etherkit/PartyLine80/README.md

# Party Line 80

## All-Discrete 80 Meter CW QRP Transceiver

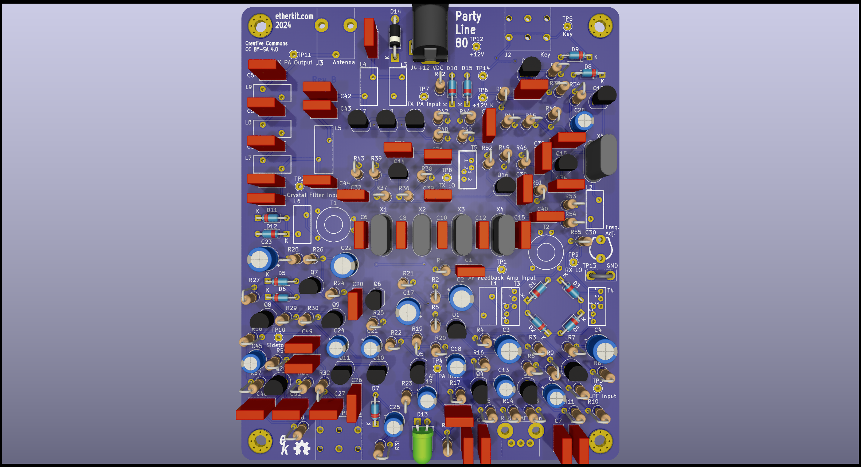
[picture p1: Documentation/PartyLine80Front.png]
Party Line 80 PCB
