etherkit/PartyLine80/Documentation/PartyLine80BlockDiagram.png

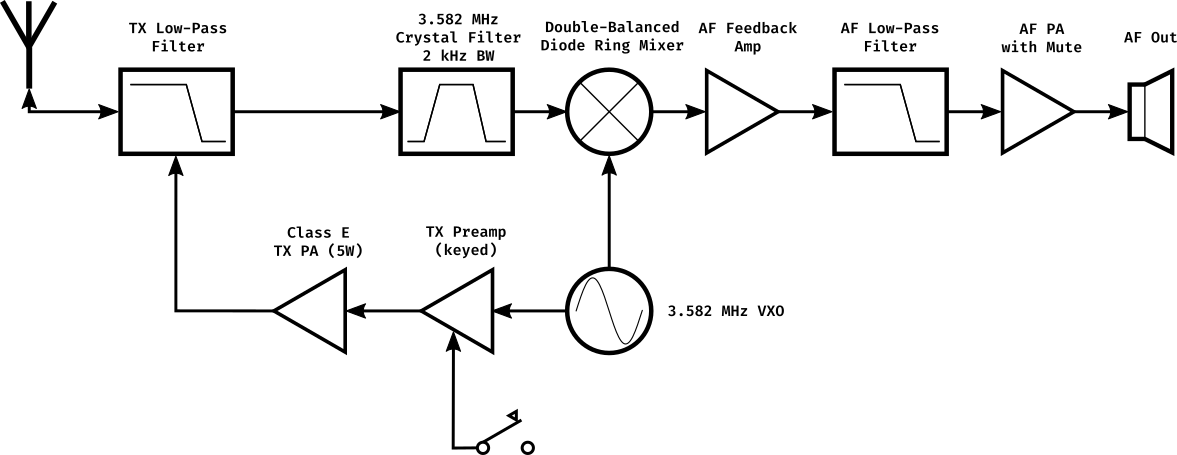
Documentation/PartyLine80BlockDiagram.png
