etherkit/PartyLine80/PCB/PartyLine80-Receiver.png

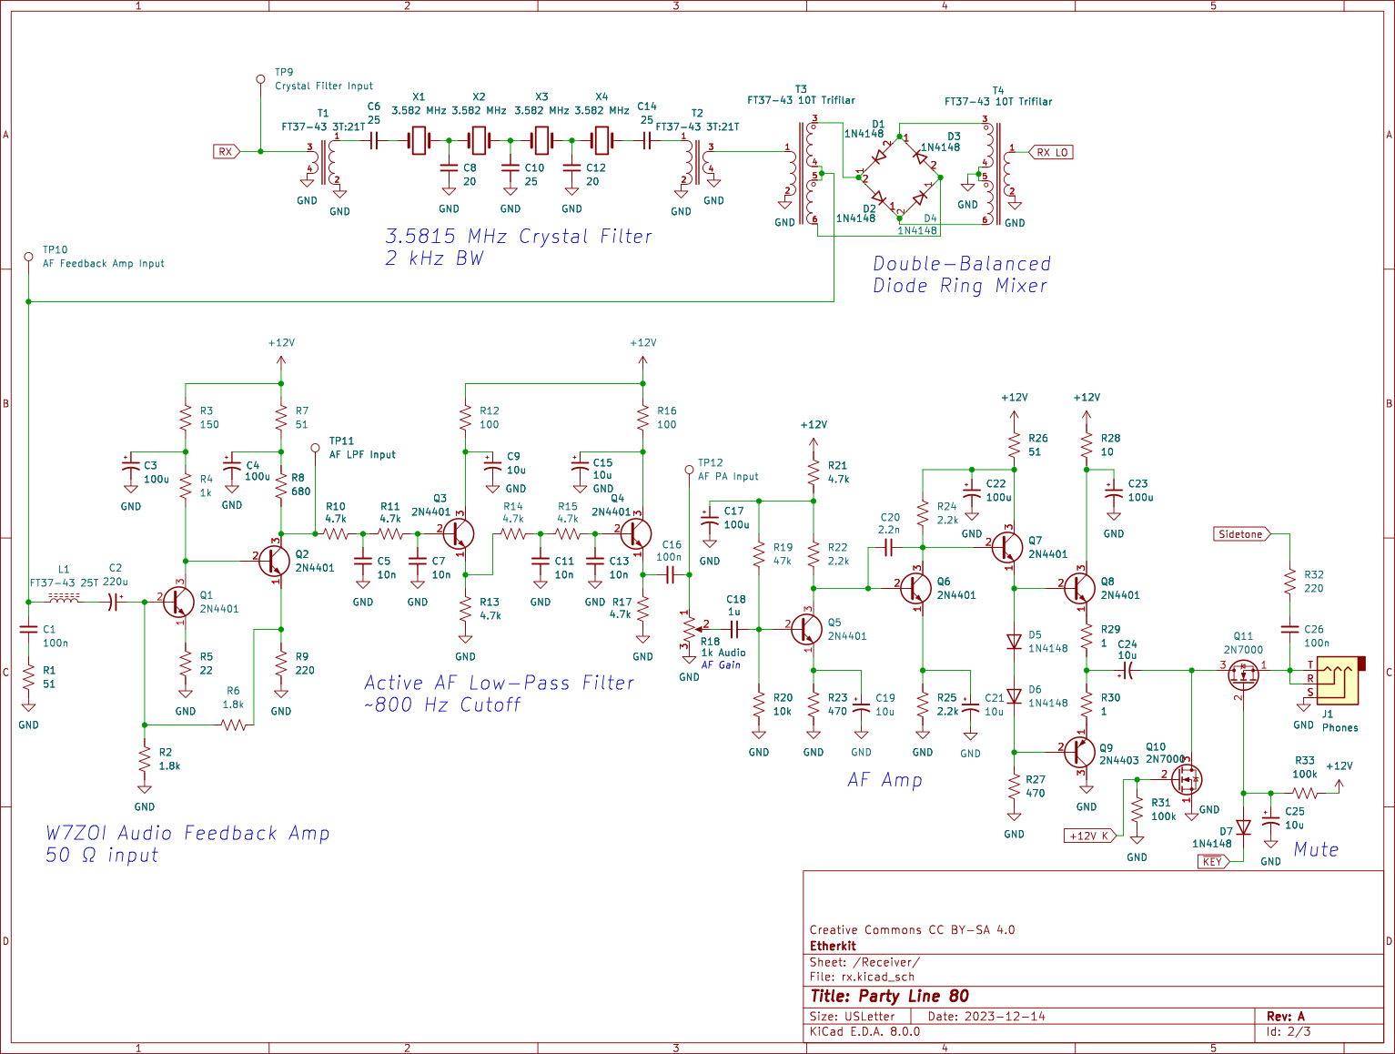
PCB/PartyLine80-Receiver.png
