etherkit/PartyLine80/Mechanical/PartyLine80CaseTop.FCStd

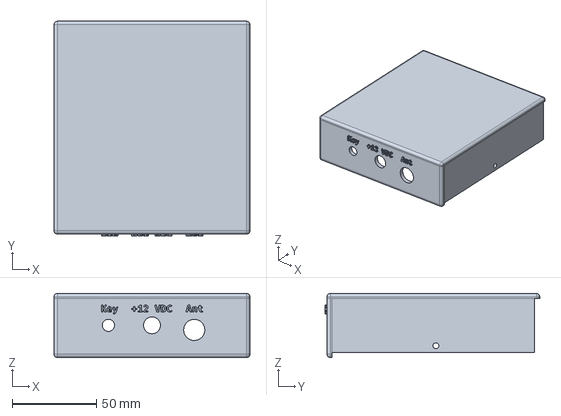
[picture p4: CAD file, 2024-05-25]
Mechanical/PartyLine80CaseTop.FCStd
116.0 x 127.0 x 38.0 mm
