etherkit/PartyLine80/Mechanical/PartyLine80CaseBottom.FCStd

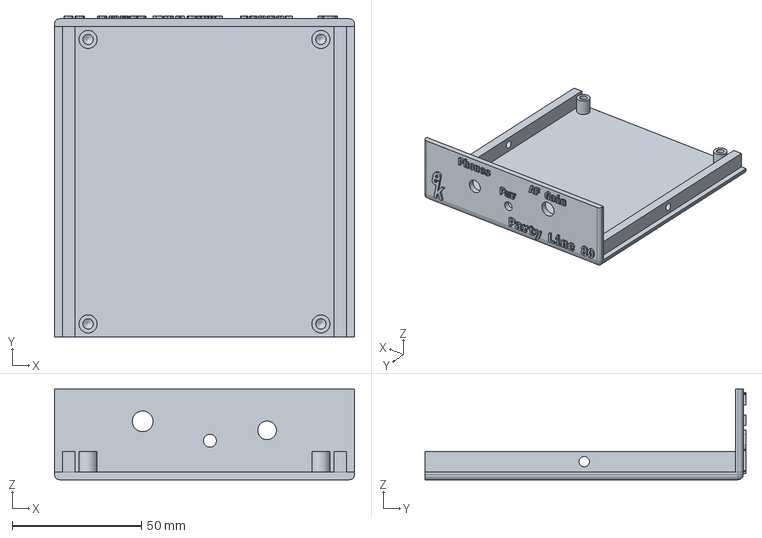
[picture p5: CAD file, 2024-05-25]
Mechanical/PartyLine80CaseBottom.FCStd
116.0 x 124.0 x 35.0 mm
