etherkit/PartyLine80/(list of files, cad)

Other CAD files:
Mechanical/PartyLine80CaseBottom.stl
Mechanical/PartyLine80CaseTop.stl
