etherkit/PartyLine80/Documentation/PartyLine80.pdf

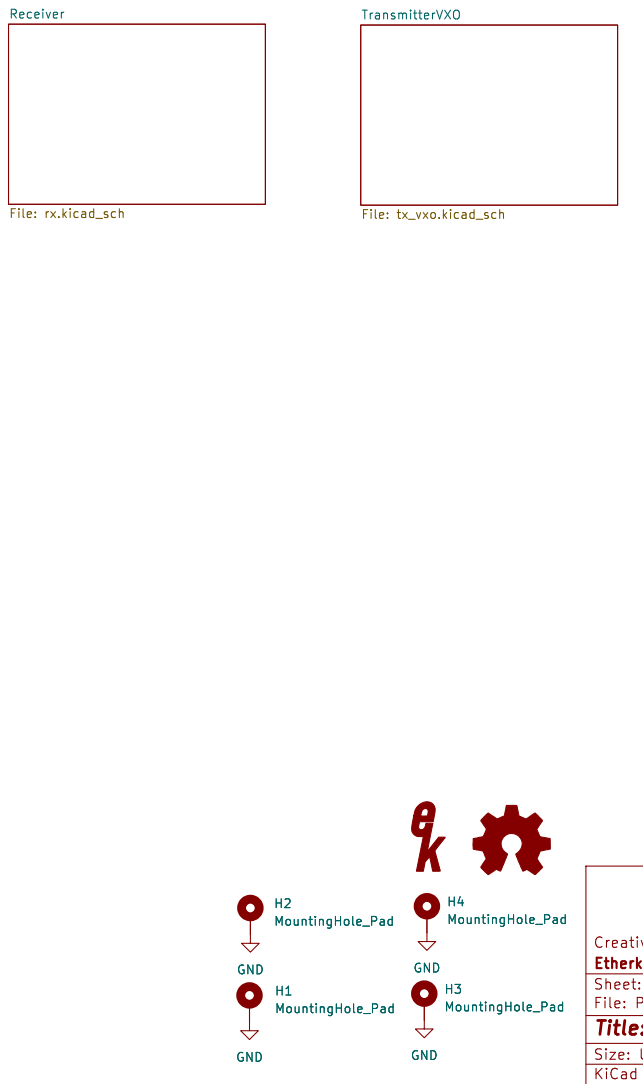
[picture p6: page 1]

Id: 1/3 Title: Party Line 80

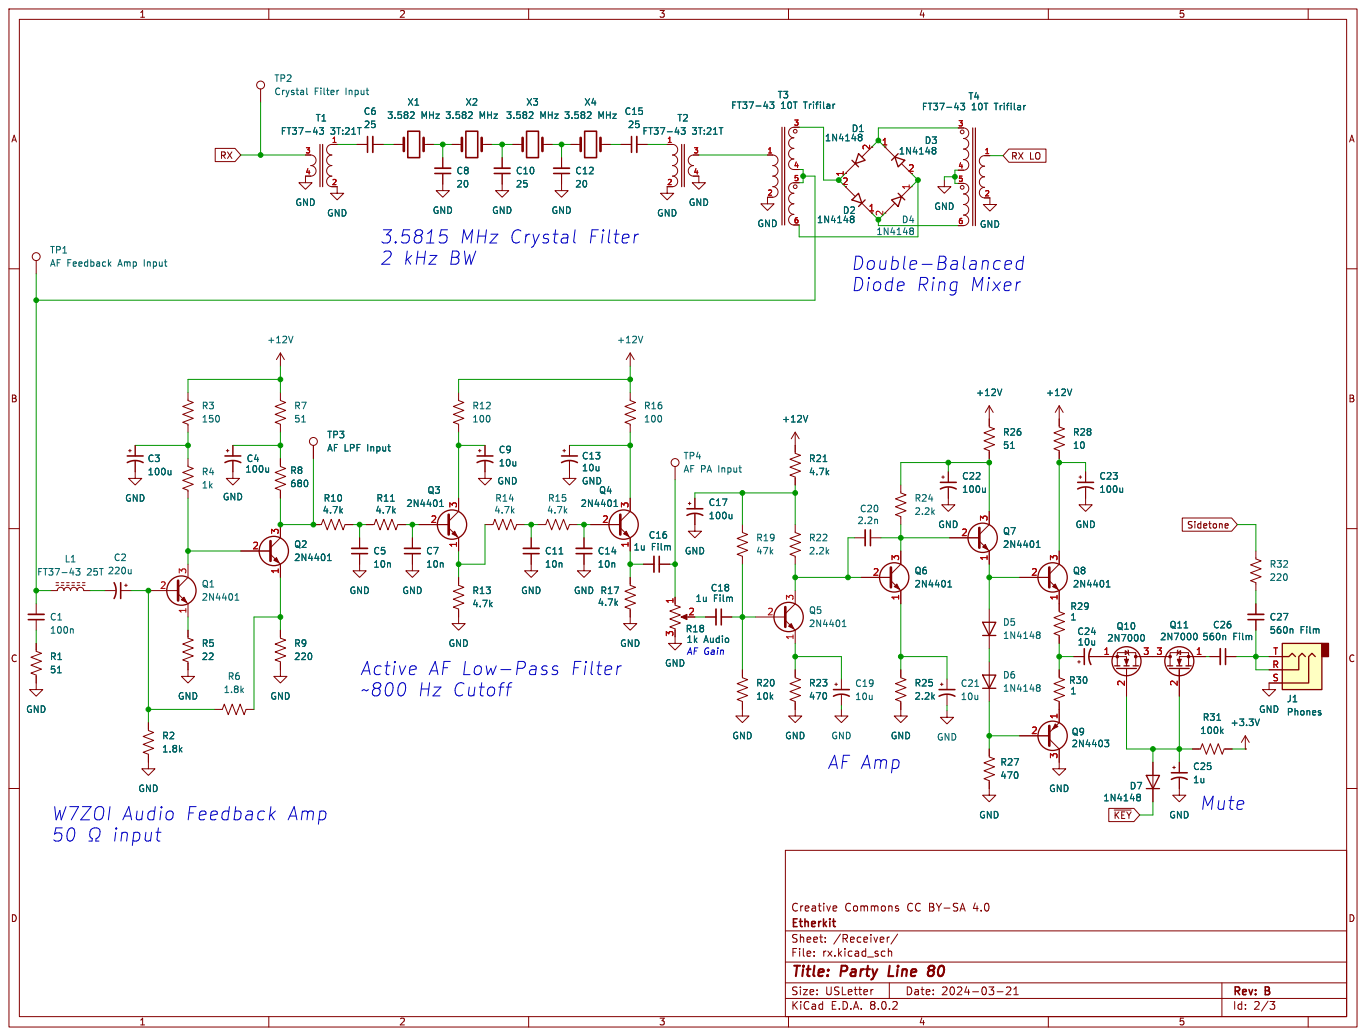
[picture p7: page 2]

Mute W7ZOI Audio Feedback Amp

Id: 2/3 Title: Party Line 80

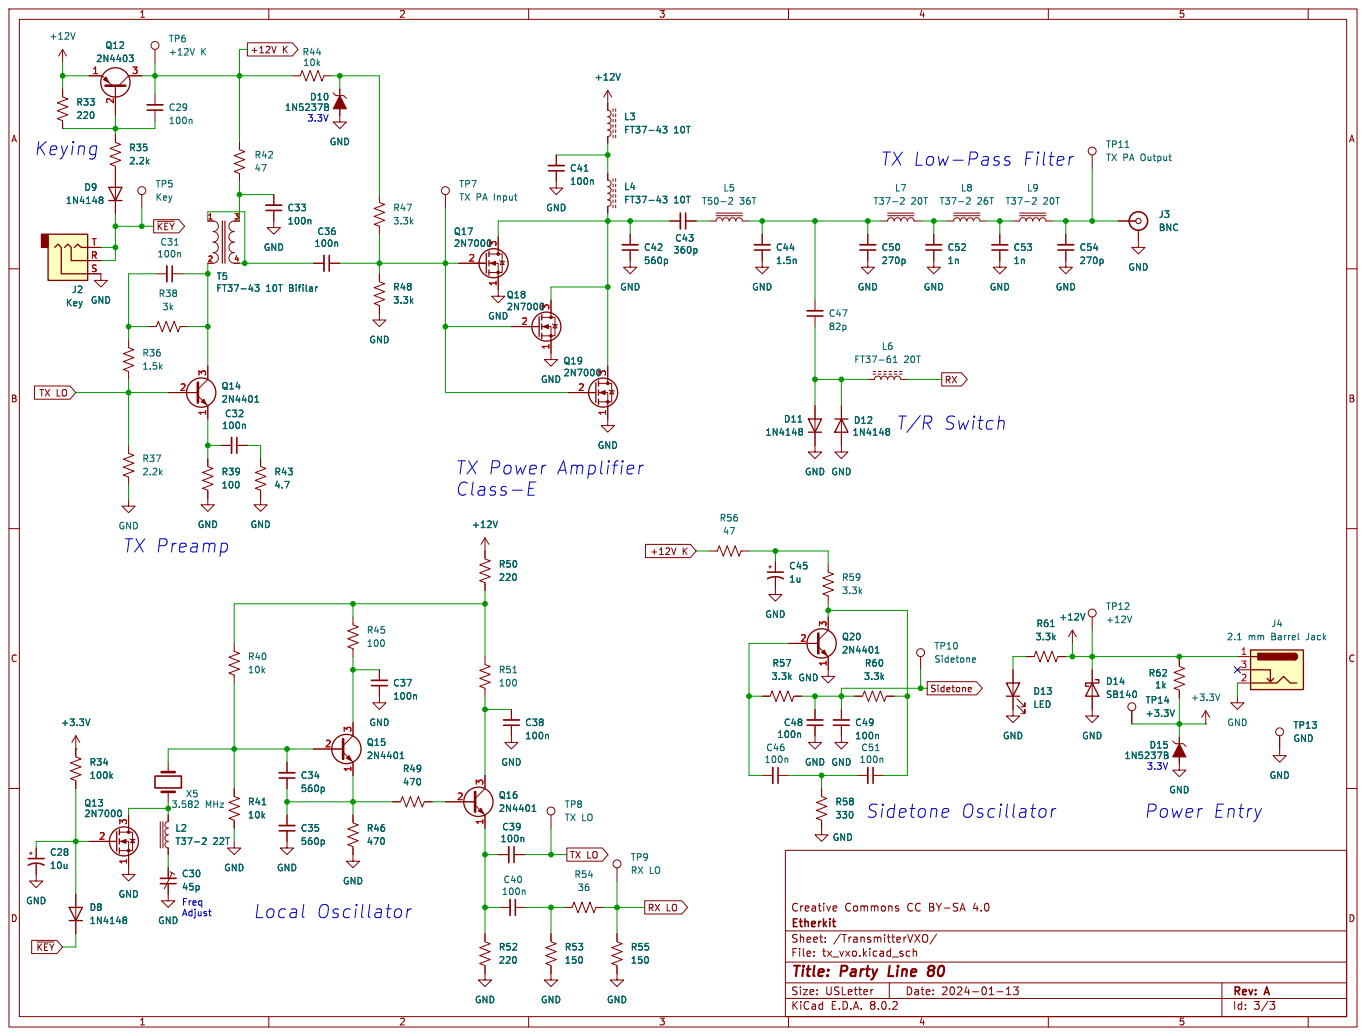
[picture p8: page 3]

2.1 mm Barrel Jack GND

Id: 3/3 Title: Party Line 80
