etherkit/PartyLine80/PCB/PartyLine80.kicad_pcb

## KiCad design PCB/PartyLine80.kicad_pcb (2024-05-25)

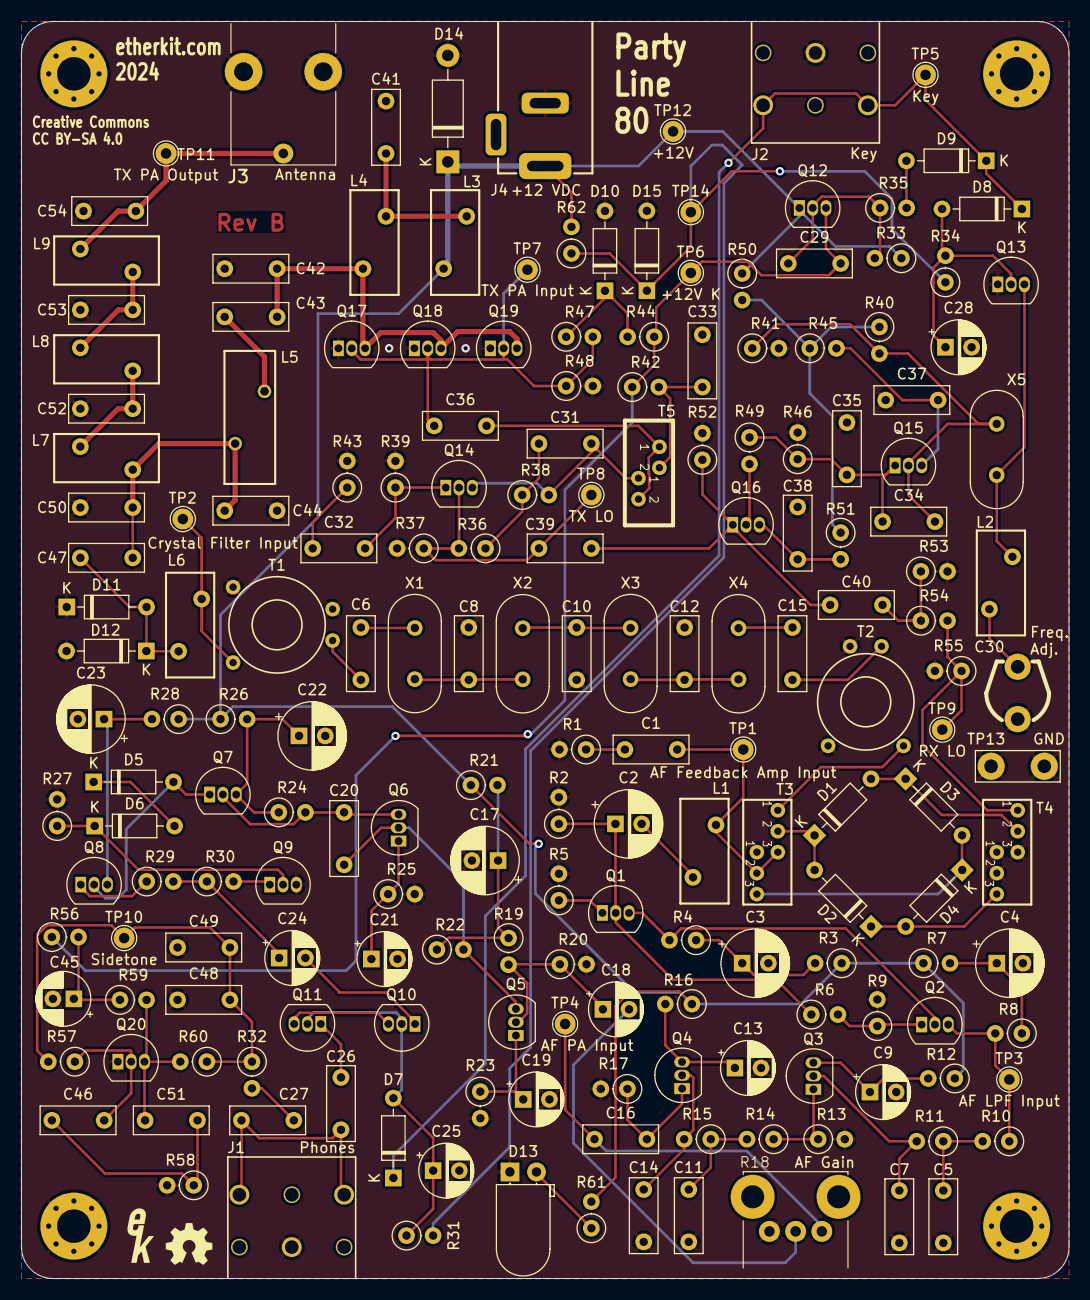
[picture p9: board PartyLine80.kicad_pcb from above]

Board: 2 copper layers, 100.0 x 120.0 mm, 194 parts (0 on the bottom side), 95 nets.

Parts:
C1, C29, C31, C32, C33, C36, C37, C38, C39, C40, C41, C46, C48, C49, C51: 100n; C_Rect_L7.0mm_W2.5mm_P5.00mm
C2: 220u; CP_Radial_D6.3mm_P2.50mm
C3, C4, C17, C22, C23: 100u; CP_Radial_D6.3mm_P2.50mm
C5, C7, C11, C14: 10n; C_Rect_L7.0mm_W2.5mm_P5.00mm
C6, C10, C15: 25; C_Rect_L7.0mm_W2.5mm_P5.00mm
C8, C12: 20; C_Rect_L7.0mm_W2.5mm_P5.00mm
C9, C13, C19, C21, C24: 10u; CP_Radial_D5.0mm_P2.50mm
C16: 1u Film; C_Rect_L7.0mm_W2.5mm_P5.00mm
C18: 1u Film; CP_Radial_D5.0mm_P2.50mm
C20: 2.2n; C_Rect_L7.0mm_W2.5mm_P5.00mm
C25, C28: 1u; CP_Radial_D5.0mm_P2.50mm
C26, C27: 560n Film; C_Rect_L7.0mm_W2.5mm_P5.00mm
C30: 45p; TRIMCAP-MURATA
C34, C35, C42: 560p; C_Rect_L7.0mm_W2.5mm_P5.00mm
C43: 360p; C_Rect_L7.0mm_W2.5mm_P5.00mm
C44: 1.5n; C_Rect_L7.0mm_W2.5mm_P5.00mm
C45: 1u; CP_Radial_D5.0mm_P2.00mm
C47: 82p; C_Rect_L7.0mm_W2.5mm_P5.00mm
C50, C54: 270p; C_Rect_L7.0mm_W2.5mm_P5.00mm
C52, C53: 1n; C_Rect_L7.0mm_W2.5mm_P5.00mm
D1, D2, D3, D4, D5, D6, D7, D8, D9, D11, D12: 1N4148; D_DO-35_SOD27_P7.62mm_Horizontal
D10, D15: 1N5237B; D_DO-35_SOD27_P7.62mm_Horizontal
D13: LED; LED_D5.0mm_Horizontal_O1.27mm_Z3.0mm
D14: SB140; D_DO-41_SOD81_P10.16mm_Horizontal
G1: LOGO; EtherkitLogoSmall
H1, H2, H3, H4: MountingHole_Pad; MountingHole_3.2mm_M3_Pad_Via
J1: Phones; Kycon_STX-3120-3B
J2: Key; Kycon_STX-3120-3B
J3: BNC; Molex_0731713150
J4: 2.1 mm Barrel Jack; CUI_PJ-202AH
L1: FT37-43 25T; T37-V
L2: T37-2 22T; T37-V
L3, L4: FT37-43 10T; T37-V
L5: T50-2 36T; T50-V
L6: FT37-61 20T; T37-V
L7, L9: T37-2 20T; T37-V
L8: T37-2 26T; T37-V
Q1, Q2, Q3, Q4, Q5, Q6, Q7, Q8, Q14, Q15, Q16, Q20: 2N4401; TO-92_Inline
Q9, Q12: 2N4403; TO-92_Inline
Q10, Q11, Q13, Q17, Q18, Q19: 2N7000; TO-92_Inline
R1, R7, R26: 51; R_Axial_DIN0207_L6.3mm_D2.5mm_P2.54mm_Vertical
R2, R6: 1.8k; R_Axial_DIN0207_L6.3mm_D2.5mm_P2.54mm_Vertical
R3, R53, R55: 150; R_Axial_DIN0207_L6.3mm_D2.5mm_P2.54mm_Vertical
R4, R62: 1k; R_Axial_DIN0207_L6.3mm_D2.5mm_P2.54mm_Vertical
R5: 22; R_Axial_DIN0207_L6.3mm_D2.5mm_P2.54mm_Vertical
R8: 680; R_Axial_DIN0207_L6.3mm_D2.5mm_P2.54mm_Vertical
R9, R32, R33, R50, R52: 220; R_Axial_DIN0207_L6.3mm_D2.5mm_P2.54mm_Vertical
R10, R11, R13, R14, R15, R17, R21: 4.7k; R_Axial_DIN0207_L6.3mm_D2.5mm_P2.54mm_Vertical
R12, R16, R39, R45, R51: 100; R_Axial_DIN0207_L6.3mm_D2.5mm_P2.54mm_Vertical
R18: 1k Audio; Bournes_PTV09A
R19: 47k; R_Axial_DIN0207_L6.3mm_D2.5mm_P2.54mm_Vertical
R20, R40, R41, R44: 10k; R_Axial_DIN0207_L6.3mm_D2.5mm_P2.54mm_Vertical
R22, R24, R25, R35, R37: 2.2k; R_Axial_DIN0207_L6.3mm_D2.5mm_P2.54mm_Vertical
R23, R27, R46, R49: 470; R_Axial_DIN0207_L6.3mm_D2.5mm_P2.54mm_Vertical
R28: 10; R_Axial_DIN0207_L6.3mm_D2.5mm_P2.54mm_Vertical
R29, R30: 1; R_Axial_DIN0207_L6.3mm_D2.5mm_P2.54mm_Vertical
R31, R34: 100k; R_Axial_DIN0207_L6.3mm_D2.5mm_P2.54mm_Vertical
R36: 1.5k; R_Axial_DIN0207_L6.3mm_D2.5mm_P2.54mm_Vertical
R38: 3k; R_Axial_DIN0207_L6.3mm_D2.5mm_P2.54mm_Vertical
R42, R56: 47; R_Axial_DIN0207_L6.3mm_D2.5mm_P2.54mm_Vertical
R43: 4.7; R_Axial_DIN0207_L6.3mm_D2.5mm_P2.54mm_Vertical
R47, R48, R57, R59, R60, R61: 3.3k; R_Axial_DIN0207_L6.3mm_D2.5mm_P2.54mm_Vertical
R54: 36; R_Axial_DIN0207_L6.3mm_D2.5mm_P2.54mm_Vertical
R58: 330; R_Axial_DIN0207_L6.3mm_D2.5mm_P2.54mm_Vertical
SYM1: Logo_Open_Hardware_Small; OSHWLogo4mm
T1, T2: FT37-43 3T:21T; T37-STEPDOWN
T3, T4: FT37-43 10T Trifilar; T37-V-TRIFILARXFMR
T5: FT37-43 10T Bifilar; T37-V-BIFILARXFMR
TP1: AF Feedback Amp Input; TestPoint_THTPad_D2.0mm_Drill1.0mm
TP2: Crystal Filter Input; TestPoint_THTPad_D2.0mm_Drill1.0mm
TP3: AF LPF Input; TestPoint_THTPad_D2.0mm_Drill1.0mm
TP4: AF PA Input; TestPoint_THTPad_D2.0mm_Drill1.0mm
TP5: Key; TestPoint_THTPad_D2.0mm_Drill1.0mm
TP6: +12V K; TestPoint_THTPad_D2.0mm_Drill1.0mm
TP7: TX PA Input; TestPoint_THTPad_D2.0mm_Drill1.0mm
TP8: TX LO; TestPoint_THTPad_D2.0mm_Drill1.0mm
TP9: RX LO; TestPoint_THTPad_D2.0mm_Drill1.0mm
TP10: Sidetone; TestPoint_THTPad_D2.0mm_Drill1.0mm
TP11: TX PA Output; TestPoint_THTPad_D2.0mm_Drill1.0mm
TP12: +12V; TestPoint_THTPad_D2.0mm_Drill1.0mm
TP13: GND; TestPoint_Bridge_Pitch5.08mm_Drill1.3mm
TP14: +3.3V; TestPoint_THTPad_D2.0mm_Drill1.0mm
X1, X2, X3, X4, X5: 3.582 MHz; Crystal_HC49-U_Vertical

Connections:
+3.3V: D15.2 (K), R31.2, R34.1, R62.1, TP14.1
+12V: D14.1 (K), J4.1, L3.1, Q12.1 (E), R3.1, R7.1, R12.1, R16.1, R21.1, R26.1, R28.1, R33.1, R50.1, R61.2, R62.2, TP12.1
+12V K: C29.2, Q12.3 (C), R42.1, R44.1, R56.1, TP6.1
GND: C3.2, C4.2, C5.1, C7.1, C8.1, C9.2, C10.1, C11.1, C12.1, C13.2, C14.1, C17.2, C19.2, C21.2, C22.2, C23.2, C25.2, C28.2, C30.2, C33.1, C35.1, C37.1, C38.1, C41.1, C42.1, C44.1, C45.2, C48.1, C49.1, C50.1, C52.1, C53.1, C54.1, D10.1 (A), D11.1 (K), D12.2 (A), D13.1 (K), D14.2 (A), D15.1 (A), H1.1, H2.1, H3.1, H4.1, J1.S, J2.S, J3.2 (Ext), J4.2, Q9.3 (C), Q13.1 (S), Q17.1 (S), Q18.1 (S), Q19.1 (S), Q20.1 (E), R1.2, R2.2, R5.2, R9.2, R13.2, R17.2, R18.3, R20.2, R23.2, R25.2, R27.2, R37.2, R39.2, R41.2, R43.2, R46.2, R48.2, R52.2, R53.2, R55.2, R58.2, T1.2, T1.4, T2.2, T2.4, T3.2, T4.2, T4.4, T4.5 (3), TP13.1
unnamed: C1.1, R1.1
unnamed: C1.2, L1.1, T3.4, T3.5 (3), TP1.1
unnamed: C2.2, L1.2
unnamed: C3.1, R3.2, R4.1
unnamed: C4.1, R7.2, R8.1
unnamed: C5.2, R10.2, R11.1
unnamed: C6.1, T1.1
unnamed: C6.2, X1.1
unnamed: C8.2, X1.2, X2.1
unnamed: C10.2, X2.2, X3.1
unnamed: C11.2, R14.2, R15.1
unnamed: C12.2, X3.2, X4.1
unnamed: C15.1, X4.2
unnamed: C15.2, T2.1
unnamed: C16.1, R18.1, TP4.1
unnamed: C17.1, R19.1, R21.2, R22.1
unnamed: C18.2, R18.2
unnamed: C24.1, R29.2, R30.1
unnamed: C26.1, C27.1, J1.R, J1.T
unnamed: C27.2, R32.2
unnamed: C30.1, L2.1
unnamed: C31.2, R36.1, R38.1
unnamed: C32.1, R43.1
unnamed: C33.2, R42.2, T5.3
unnamed: C36.2, T5.1, T5.4
unnamed: C40.1, R53.1, R54.1
unnamed: C41.2, L3.2, L4.1
unnamed: C43.1, L5.1
unnamed: C44.2, C47.2, C50.2, L5.2, L7.1
unnamed: C45.1, R56.2, R59.1
unnamed: C46.1, C51.2, R58.1
unnamed: C52.2, L7.2, L8.1
unnamed: C53.2, L8.2, L9.1
unnamed: D1.1, D2.2, T3.3
unnamed: D1.2, D3.1, T4.3
unnamed: D2.1, D4.2, T4.6 (4)
unnamed: D3.2, D4.1, T3.6 (4)
unnamed: D5.2 (A), Q7.1 (E), Q8.2 (B)
unnamed: D5.1 (K), D6.2 (A)
unnamed: D6.1 (K), Q9.2 (B), R27.1
unnamed: C25.1, D7.2 (A), Q10.2 (G), Q11.2 (G), R31.1
unnamed: C28.1, D8.2 (A), Q13.2 (G), R34.2
unnamed: D9.2 (A), R35.2
unnamed: D10.2 (K), R44.2, R47.1
unnamed: C47.1, D11.2 (A), D12.1 (K), L6.1
unnamed: D13.2 (A), R61.1
unnamed: C54.2, J3.1 (In), L9.2, TP11.1
unnamed: C2.1, Q1.2 (B), R2.1, R6.1
unnamed: Q1.3 (C), Q2.2 (B), R4.2
unnamed: Q1.1 (E), R5.1
unnamed: Q2.3 (C), R8.2, R10.1, TP3.1
unnamed: Q2.1 (E), R6.2, R9.1
unnamed: C7.2, Q3.2 (B), R11.2
unnamed: C9.1, Q3.3 (C), R12.2
unnamed: Q3.1 (E), R13.1, R14.1
unnamed: C14.2, Q4.2 (B), R15.2
unnamed: C13.1, Q4.3 (C), R16.2
unnamed: C16.2, Q4.1 (E), R17.1
unnamed: C18.1, Q5.2 (B), R19.2, R20.1
unnamed: C20.2, Q5.3 (C), Q6.2 (B), R22.2
unnamed: C19.1, Q5.1 (E), R23.1
unnamed: C20.1, Q6.3 (C), Q7.2 (B), R24.2
unnamed: C21.1, Q6.1 (E), R25.1
unnamed: C22.1, Q7.3 (C), R24.1, R26.2
unnamed: C23.1, Q8.3 (C), R28.2
unnamed: Q8.1 (E), R29.1
unnamed: Q9.1 (E), R30.2
unnamed: Q10.3 (D), Q11.3 (D)
unnamed: C24.2, Q10.1 (S)
unnamed: C26.2, Q11.1 (S)
unnamed: C29.1, Q12.2 (B), R33.2, R35.1
unnamed: L2.2, Q13.3 (D), X5.1
unnamed: C31.1, Q14.3 (C), R38.2, T5.2
unnamed: C32.2, Q14.1 (E), R39.1
unnamed: C34.2, Q15.2 (B), R40.2, R41.1, X5.2
unnamed: C37.2, Q15.3 (C), R45.2
unnamed: C34.1, C35.2, Q15.1 (E), R46.1, R49.1
unnamed: Q16.2 (B), R49.2
unnamed: C38.2, Q16.3 (C), R51.2
unnamed: C39.2, C40.2, Q16.1 (E), R52.1
unnamed: C42.2, C43.2, L4.2, Q17.3 (D), Q18.3 (D), Q19.3 (D)
unnamed: C36.1, Q17.2 (G), Q18.2 (G), Q19.2 (G), R47.2, R48.1, TP7.1
unnamed: C46.2, Q20.2 (B), R57.1
unnamed: C51.1, Q20.3 (C), R59.2, R60.2
unnamed: R40.1, R45.1, R50.2, R51.1
unnamed: T2.3, T3.1
RX: L6.2, T1.3, TP2.1
RX LO: R54.2, R55.1, T4.1, TP9.1
Sidetone: C48.2, C49.2, R32.1, R57.2, R60.1, TP10.1
TX LO: C39.1, Q14.2 (B), R36.2, R37.1, TP8.1
~KEY: D7.1 (K), D8.1 (K), D9.1 (K), J2.R, J2.T, TP5.1
