etherkit/PartyLine80/(commit log)

2024-01-19 Add basic build instructions
    [PartyLine80-B_Cu.gbl, PartyLine80-B_Mask.gbs, PartyLine80-B_Paste.gbp, PartyLine80-B_Silkscreen.gbo, PartyLine80-Edge_Cuts.gm1, PartyLine80-F_Cu.gtl, PartyLine80-F_Mask.gts, PartyLine80-F_Paste.gtp]
2024-05-25 Party Line 80 PCB Rev B
    [PartyLine80-B_Cu.gbl, PartyLine80-B_Mask.gbs, PartyLine80-B_Paste.gbp, PartyLine80-B_Silkscreen.gbo, PartyLine80-Edge_Cuts.gm1, PartyLine80-F_Cu.gtl, PartyLine80-F_Mask.gts, PartyLine80-F_Paste.gtp]
2024-05-25 Update rendering of PCB
