etherkit/PartyLine80/(notices)

Notices in the files:
PCB/PartyLine80.kicad_sch:
Creative Commons CC BY-SA 4.0
PCB/PartyLine80.kicad_pcb:
CC BY-SA 4.0
